jdesbonnet/WombatMedical/hardware/ecg/prototype1/pcb/ecg.brd

## EAGLE design hardware/ecg/prototype1/pcb/ecg.brd (2013-10-01)

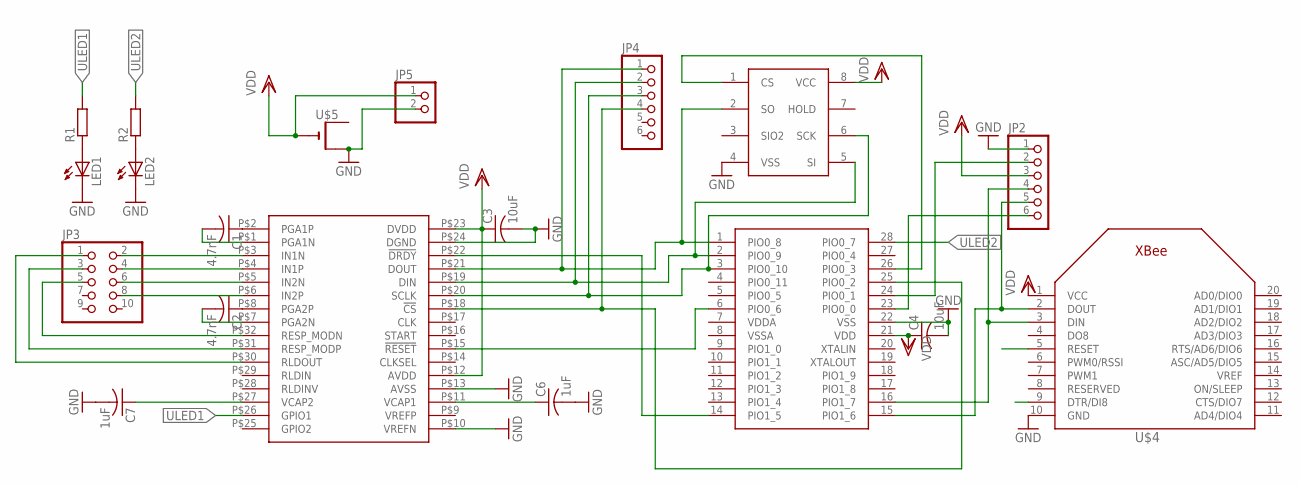
[picture p3: schematic ecg.sch]

Parts:
C1, C2: 4.7nF; C0805
C3, C4: 10uF; C0805
C6, C7: 1uF; C0805
JP2, JP4: PINHD-1X6; 1X06
JP3: PINHD-2X5; 2X05
JP5: PINHD-1X2; 1X02
LED1, LED2: LED3MM
R1, R2: R-EU_R0805; R0805
U$1: ADS1929R; TQFP32
U$2: LPC1114FN28; DIL28-6
U$3: 23A1024; DIL08
U$4: XBEE
U$5: CR2032SMT; CR2032-SMD

Connections:
GND: C3.2, C4.2, C6.2, C7.2, JP2.1, JP5.2, LED1.K (C), LED2.K (C), U$1.P$10 (VREFN), U$1.P$13 (AVSS), U$1.P$24 (DGND), U$2.22 (VSS), U$3.4 (VSS), U$4.10 (GND), U$5.+$2 (+1)
unnamed: C1.1, U$1.P$2 (PGA1P)
unnamed: C1.2, U$1.P$1 (PGA1N)
unnamed: C2.1, U$1.P$8 (PGA2P)
unnamed: C2.2, U$1.P$7 (PGA2N)
unnamed: JP4.1, U$1.P$21 (DOUT), U$2.1 (PIO0_8), U$3.2 (SO)
unnamed: JP4.2, U$1.P$19 (DIN), U$2.2 (PIO0_9), U$3.5 (SI)
unnamed: JP4.3, U$1.P$20 (SCLK), U$2.3 (PIO0_10), U$3.6 (SCK)
unnamed: JP4.4, U$1.P$18 (!CS!), U$2.25 (PIO0_2)
unnamed: U$1.P$22 (!DRDY!), U$2.14 (PIO1_5)
unnamed: JP3.2, U$1.P$3 (IN1N)
unnamed: JP3.4, U$1.P$4 (IN1P)
unnamed: JP3.6, U$1.P$5 (IN2N)
unnamed: JP3.8, U$1.P$6 (IN2P)
unnamed: U$1.P$15 (!RESET!), U$2.6 (PIO0_6)
unnamed: JP3.5, U$1.P$32 (RESP_MODN)
unnamed: JP3.3, U$1.P$31 (RESP_MODP)
unnamed: JP3.1, U$1.P$30 (RLDOUT)
unnamed: JP2.6, U$2.23 (PIO0_0)
unnamed: U$2.26 (PIO0_3), U$3.1 (CS)
unnamed: JP2.5, U$2.15 (PIO1_6), U$4.2 (DOUT)
unnamed: JP2.4, U$2.16 (PIO1_7), U$4.3 (DIN)
unnamed: JP2.2, U$2.24 (PIO0_1)
unnamed: C6.1, U$1.P$11 (VCAP1)
unnamed: LED1.A, R1.1
unnamed: LED2.A, R2.1
unnamed: C7.1, U$1.P$27 (VCAP2)
ULED1: R1.2, U$1.P$26 (GPIO1)
ULED2: R2.2, U$2.28 (PIO0_7)
VDD: C3.1, C4.1, JP2.3, JP5.1, U$1.P$12 (AVDD), U$1.P$23 (DVDD), U$2.21 (VDD), U$3.8 (VCC), U$4.1 (VCC), U$5.-

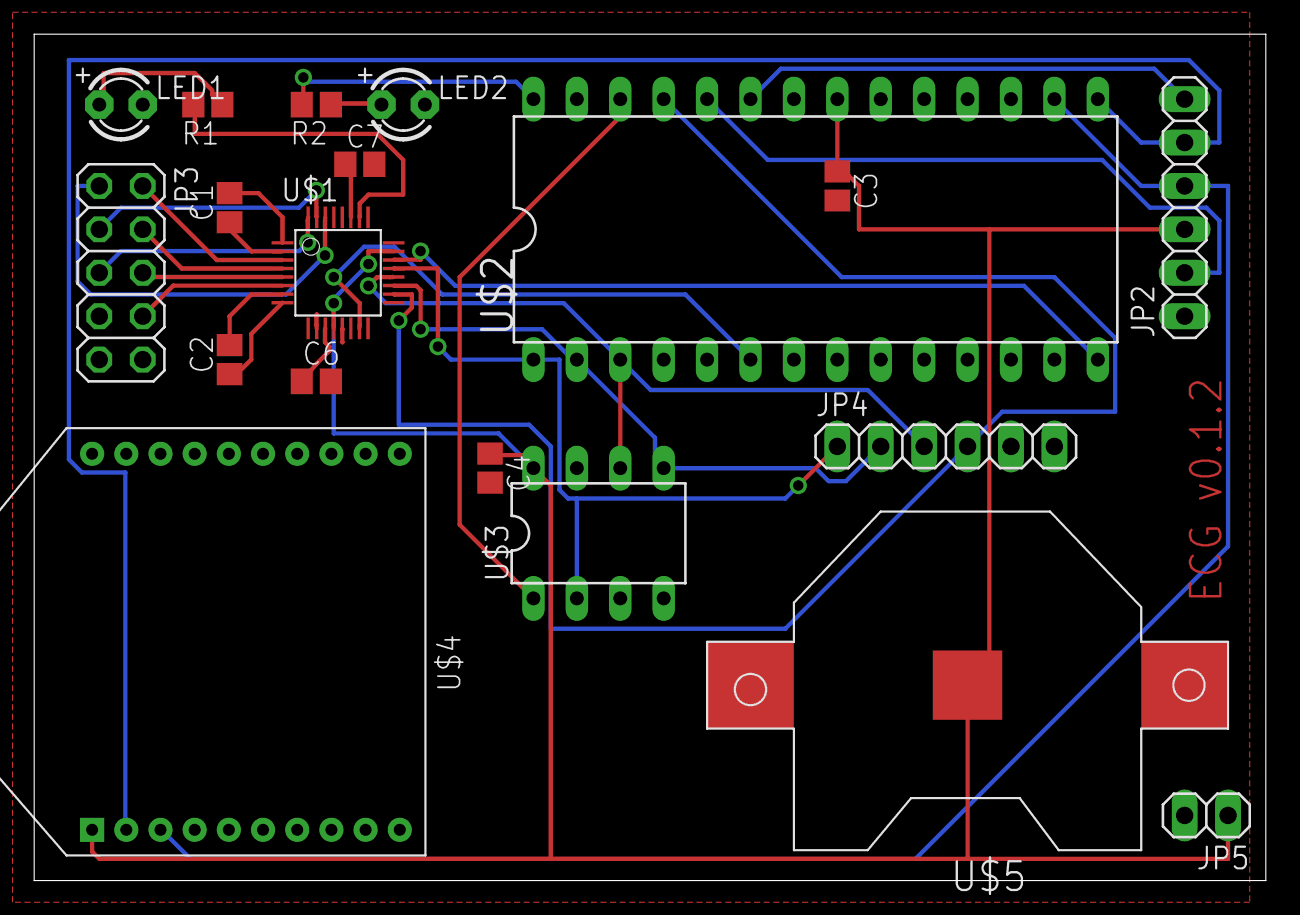
[picture p4: board ecg.brd from above]

Board: 2 copper layers, 72.1 x 49.5 mm, 19 parts (0 on the bottom side), 30 nets.
