jdesbonnet/WombatMedical/(commit log)

2013-07-13 first commit of board layout and schematics
    [ecg.brd, ecg.sch]
2013-07-14 no comment
    [ecg.brd, ecg.sch]
2013-10-01 PCB v0.1.2, sent to EuroCircuits for fab.
    [ecg.brd, ecg.sch]
2017-03-05 add missing PNG renderings of 2013 ECG prototype
2017-03-05 300dpi version of PCB layout
2017-03-05 some doc on ecg pcb
2017-03-05 JP2 (UART) header pinout
2017-03-05 more doc on pcb
2017-03-05 Octave/MATLAB script to filter 50Hz mains noise from ECG
2017-03-05 chart to show effect of 50Hz filtering
2017-03-05 add ref to 50Hz filter tutorial video
